kenchangh/kensat/docs/README.md

# Documentation

| Document | Contents |
|---|---|
| [system-architecture.md](system-architecture.md) | The full KENSAT spec: mission, physical stack, processor, interface map and pinouts, operational modes, deployment state machine, reliability, power budget, thermal analysis |
| [radio-guide.md](radio-guide.md) | UHF radio bring-up and operating guide |
| [jetson-startup.md](jetson-startup.md) | Jetson payload boot / inference timing and bring-up |
| [debug-si4463.md](debug-si4463.md) | Si4463 transceiver debugging notes |
| [spi-debug-notes.md](spi-debug-notes.md) | SPI signal-integrity debugging across the board-to-board bus |

> Vendor datasheets and manuals (PIC24 / PPM, Salvo, etc.) are not redistributed
> here; obtain them from the respective vendors.
