kenchangh/kensat/radio/rf-design/before_vna_smith.png

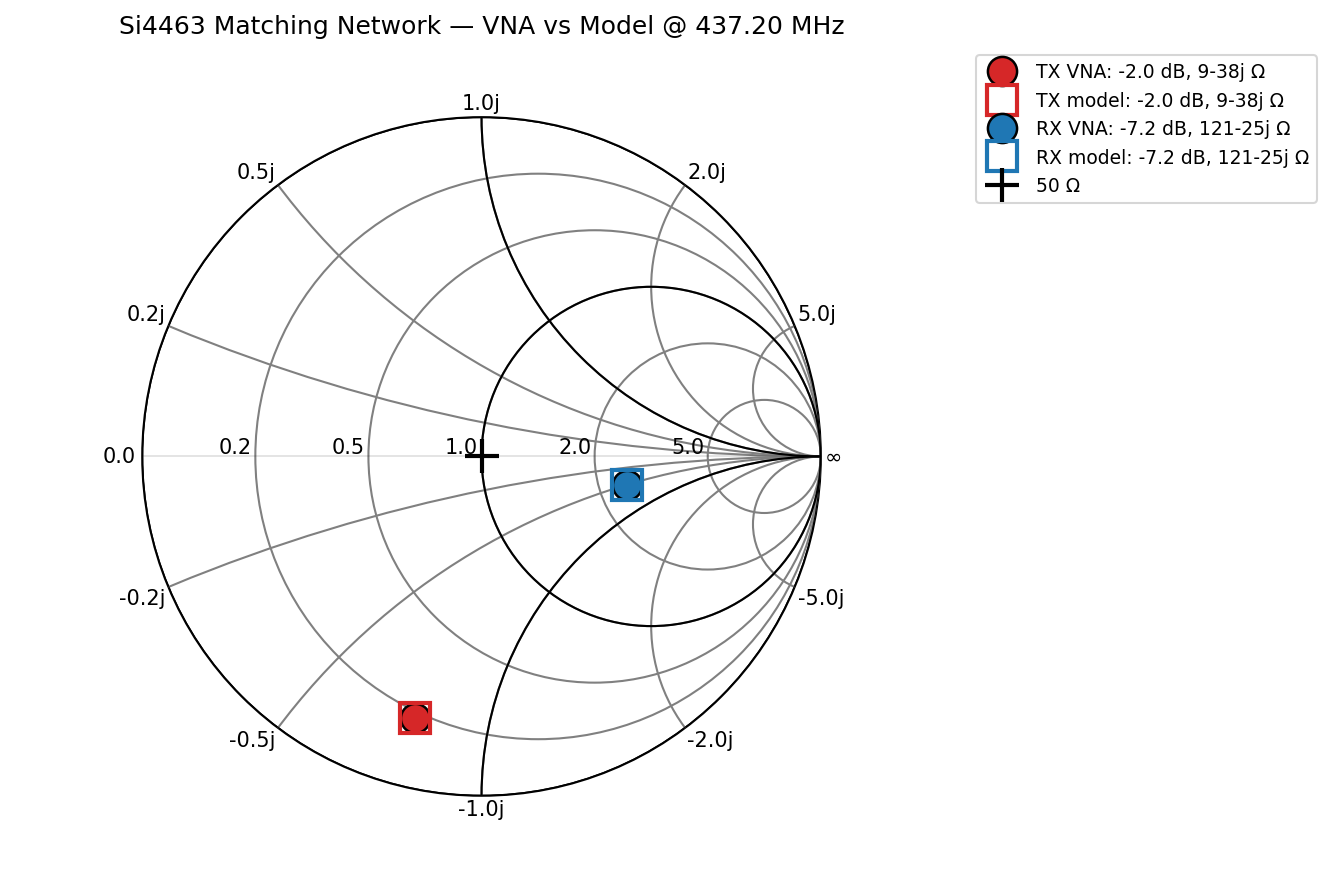
radio/rf-design/before_vna_smith.png
