kenchangh/kensat/radio/rf-design/matching_skrf.png

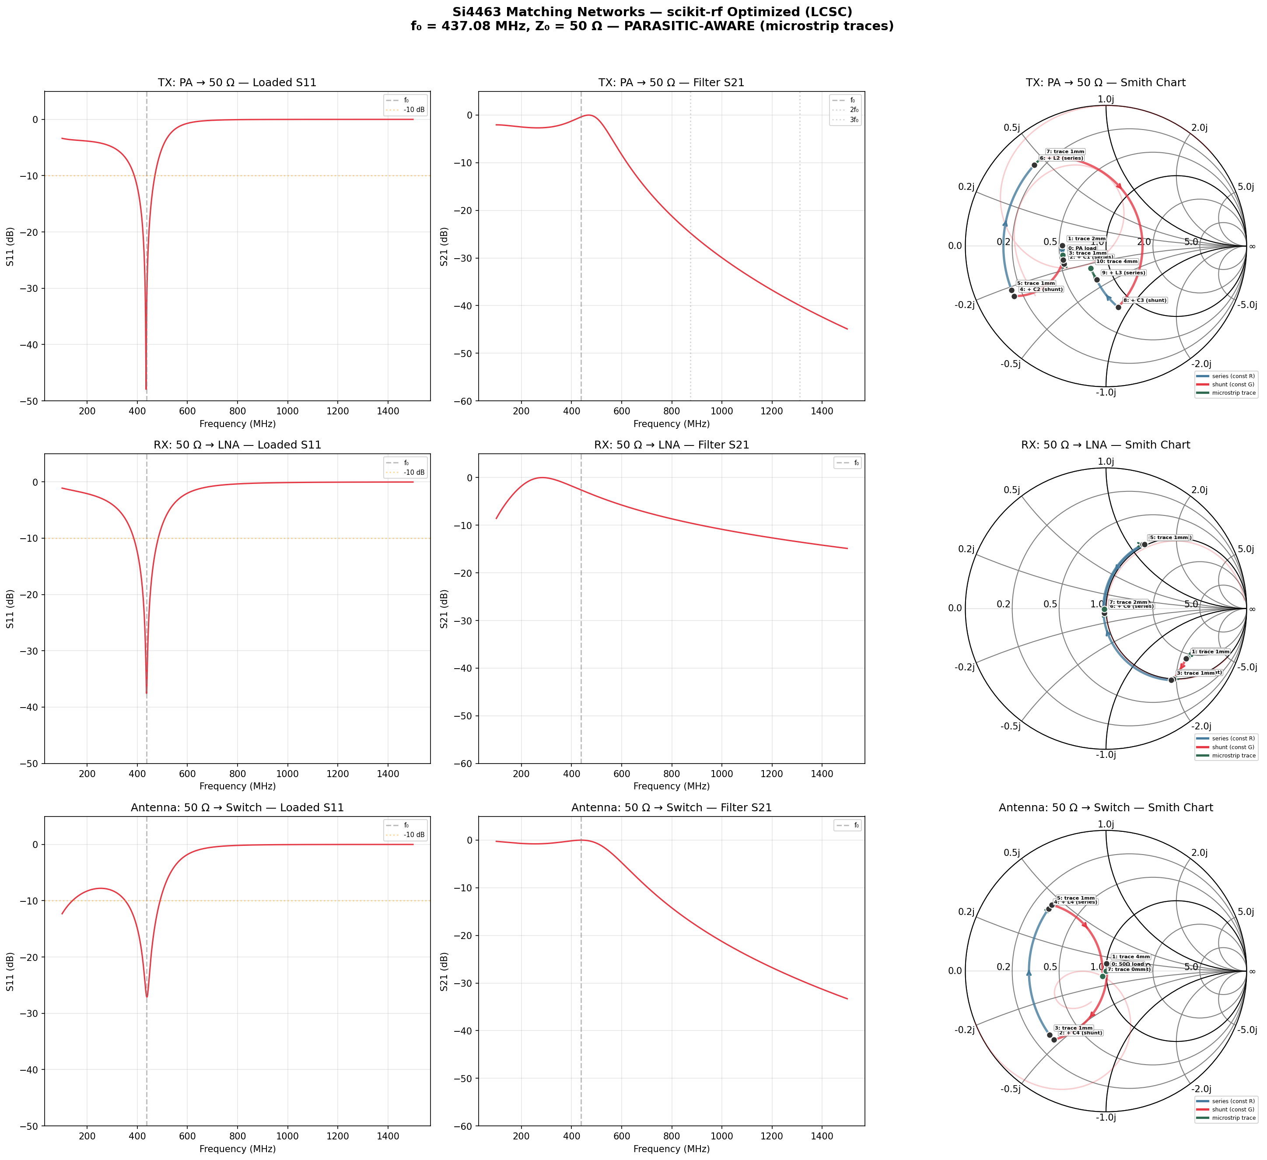
radio/rf-design/matching_skrf.png
