kenchangh/kensat/radio/rf-design/rf_architecture.png

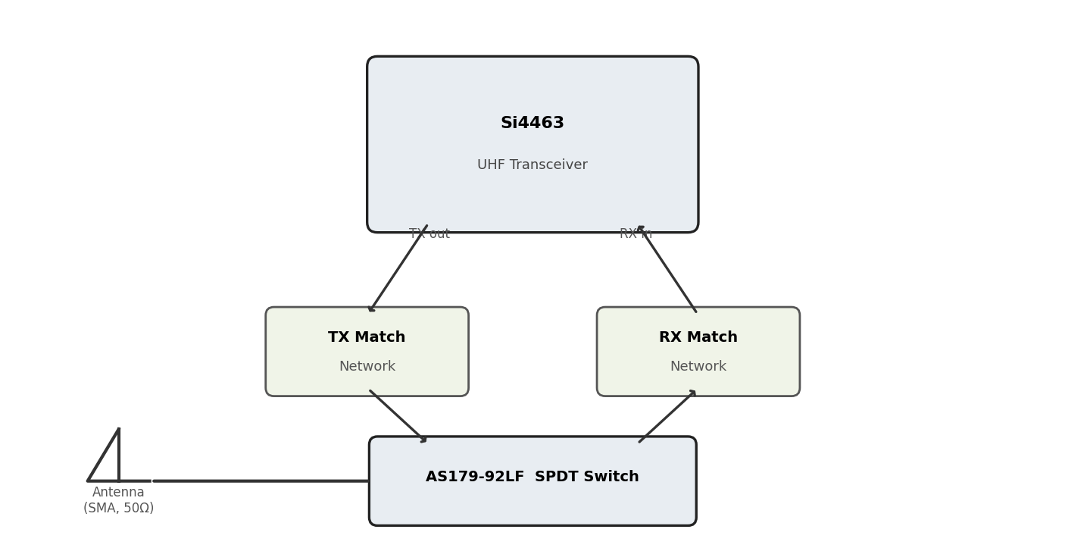
radio/rf-design/rf_architecture.png
