kenchangh/kensat/radio/rf-design/tx_gain_sweep.png

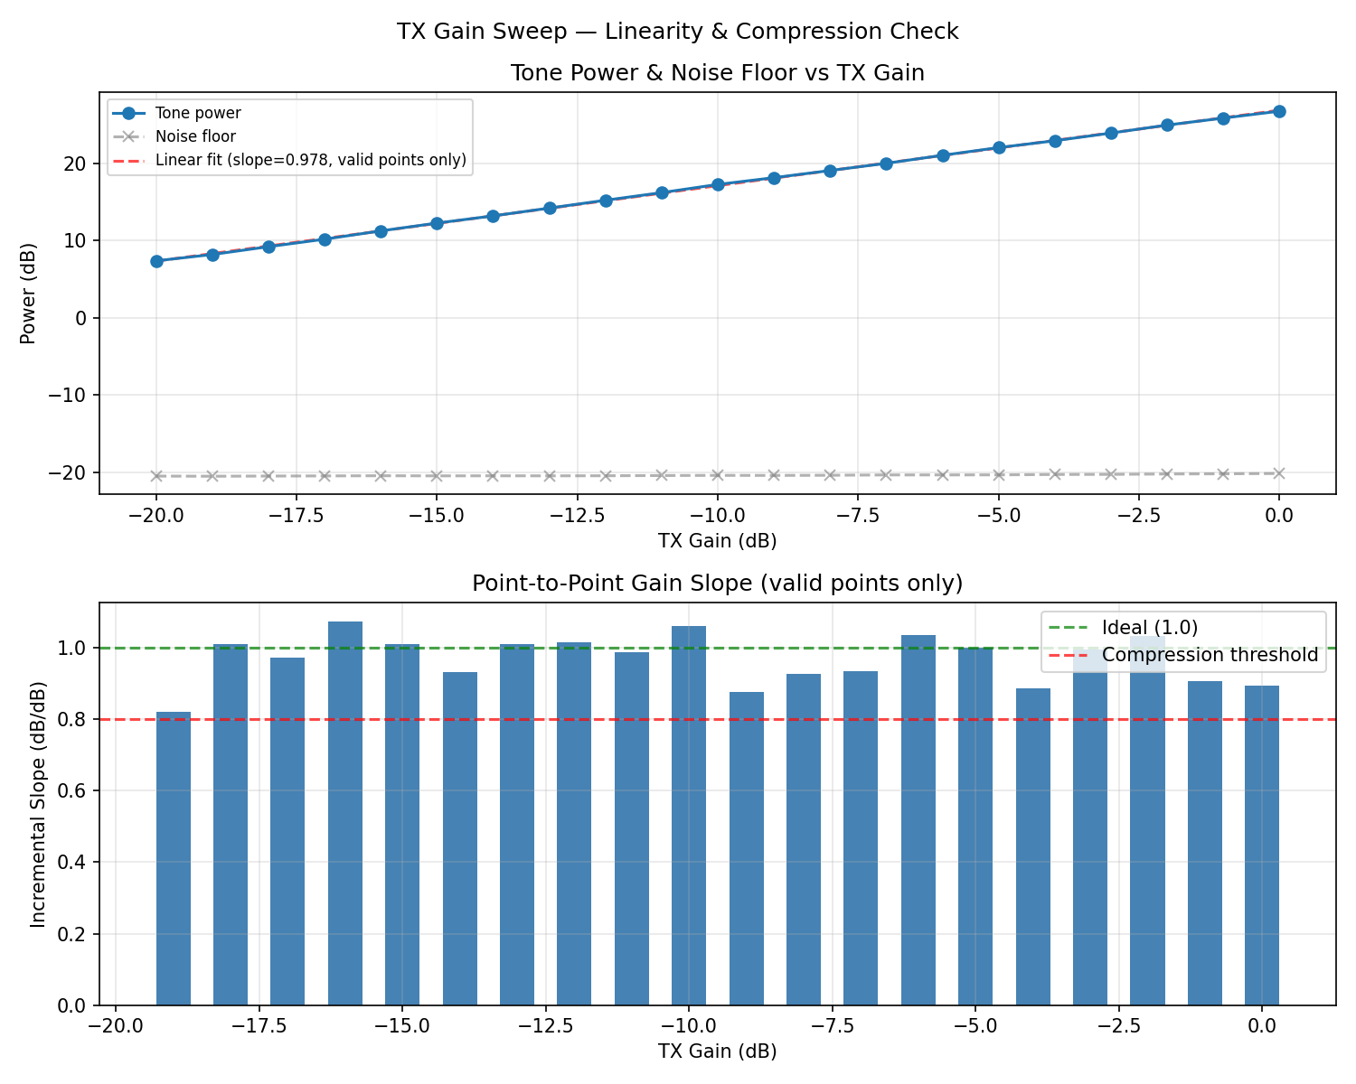
radio/rf-design/tx_gain_sweep.png
