kenchangh/kensat/radio/rf-design/tx_harmonics.png

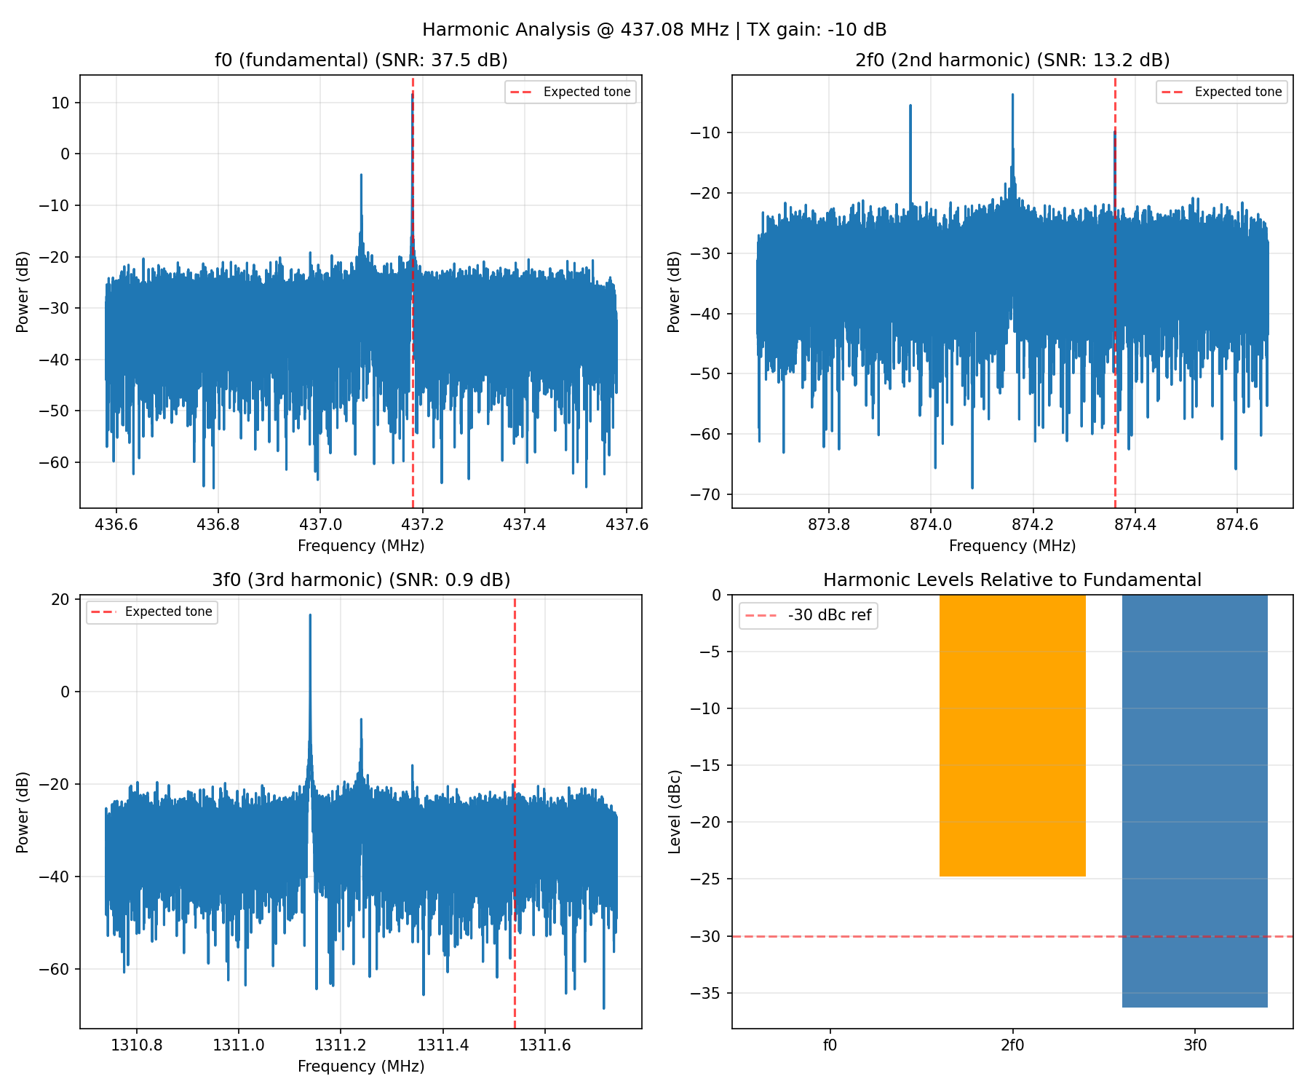
radio/rf-design/tx_harmonics.png
