kenchangh/kensat/radio/rf-design/vna_smith.png

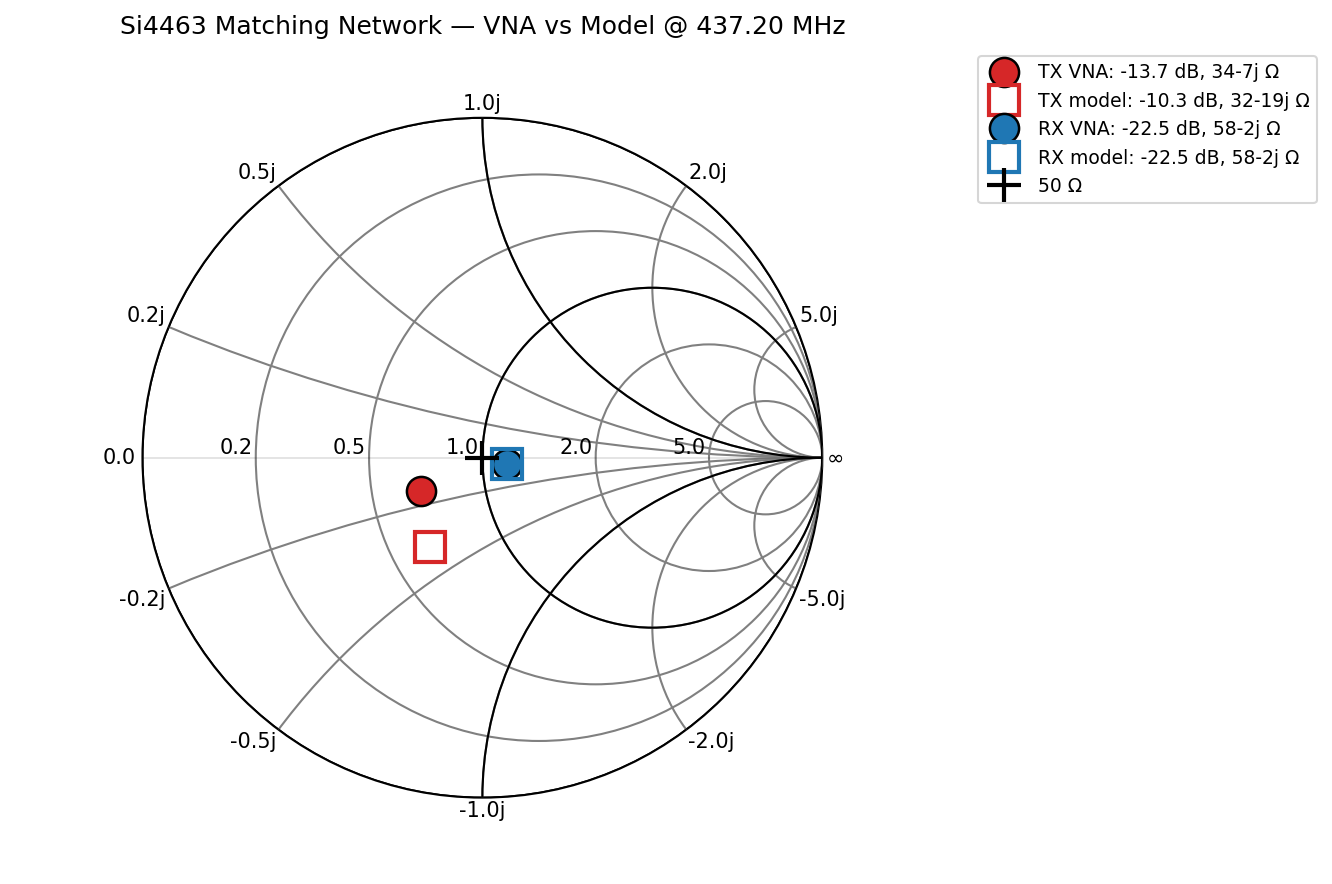
radio/rf-design/vna_smith.png
