kenchangh/kensat/burnwire/hardware/burnwire_bom_jlc.csv

Comment | Designator | Footprint | LCSC Part #
Conn_02x26_Odd_Even | H1,H2 | PinSocket_2x26_P2.54mm_Vertical | C7466599
AO3400A | Q1,Q2 | SOT-23 | C20917
100 | R1,R3 | R_Axial_DIN0207_L6.3mm_D2.5mm_P10.16mm_Horizontal | C120031
100k | R2,R4 | R_Axial_DIN0207_L6.3mm_D2.5mm_P10.16mm_Horizontal | C172965
