kenchangh/kensat/eps/hardware/KENSAT_EPS_v1.2.kicad_pcb

## KiCad design eps/hardware/KENSAT_EPS_v1.2.kicad_pcb (2026-06-17)

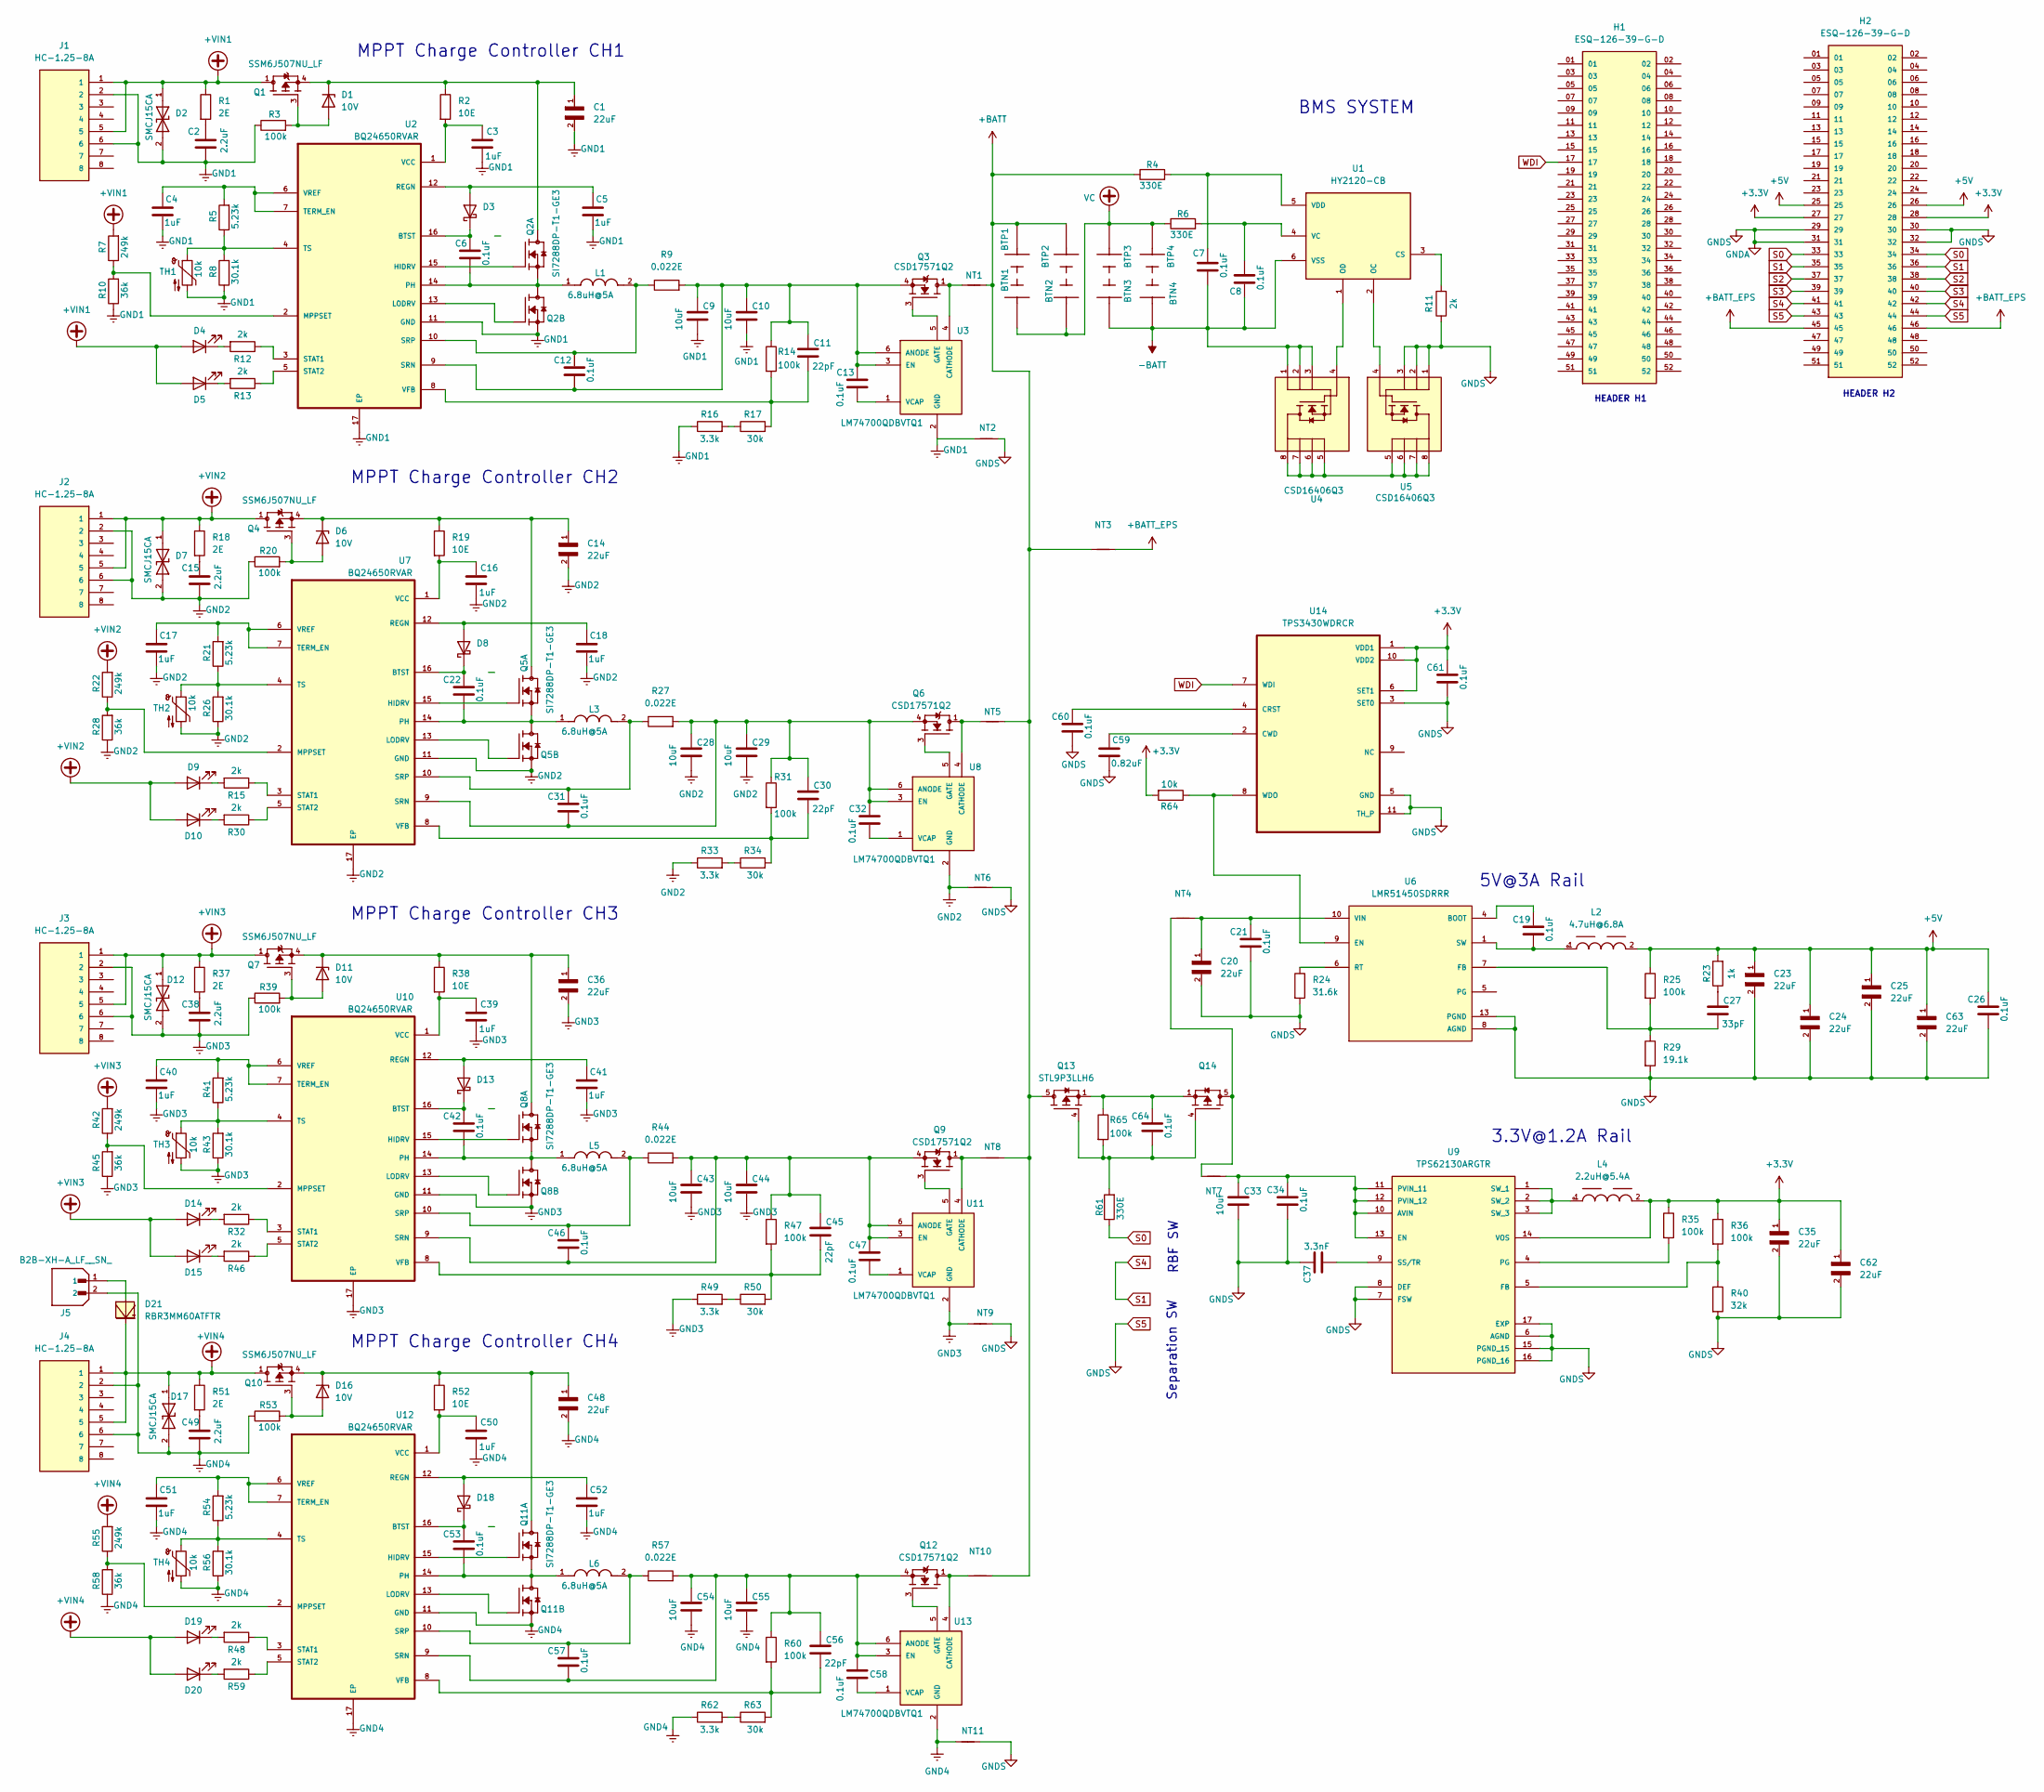
[picture p8: schematic KENSAT_EPS_v1.2.kicad_sch, KENSAT EPS Board]

Parts:
BTN1, BTN2, BTN3, BTN4: MY-18650-02; BAT_254TR; PARTREV C; LCSC Part C2979182
BTP1, BTP2, BTP3, BTP4: MY-18650-02; BAT_254TR; PARTREV C; LCSC Part C2979182
C1, C14, C20, C23, C24, C25, C35, C36, C48, C62, C63: 22uF; CAPC3225X270N; Voltage 35V; LCSC Part C386098
C2, C15, C38, C49: 2.2uF; C_1210_3225Metric; Voltage 100V; LCSC Part C92775
C3, C4, C5, C16, C17, C18, C39, C40, C41, C50, C51, C52: 1uF; C_0603_1608Metric; Voltage 35V; LCSC Part C841050
C6, C7, C8, C12, C13, C19, C21, C22, C26, C31, C32, C34, C42, C46, C47, C53, C57, C58, C60, C61, C64: 0.1uF; C_0603_1608Metric; Voltage 50V; LCSC Part C386155
C9, C10, C28, C29, C33, C43, C44, C54, C55: 10uF; C_1210_3225Metric; Voltage 35V; LCSC Part C2177081
C11, C30, C45, C56: 22pF; C_0603_1608Metric; Voltage 50V; LCSC Part C2169931
C27: 33pF; C_0603_1608Metric; Voltage 16V; LCSC Part C2169365
C37: 3.3nF; C_0603_1608Metric; Voltage 50V; LCSC Part C107088
C59: 0.82uF; C_0603_1608Metric; Voltage 25V; LCSC Part C5360807
D1, D6, D11, D16: 10V; D_SOD-123; LCSC Part C49435551
D2, D7, D12, D17: SMCJ15CA; DIOM7959X262N; PARTREV 11/20/15; LCSC Part C2842380
D3, D8, D13, D18: D_Schottky; D_SOD-323; LCSC Part C151503
D4, D9, D14, D19: LED; R_0603_1608Metric; LCSC Part C125099
D5, D10, D15, D20: LED; R_0603_1608Metric; LCSC Part C125093
D21: RBR3MM60ATFTR; SOD-123FL-2; LCSC Part C559758
H1, H2: ESQ-126-39-G-D; PARTREV R; LCSC Part C7466599
J1, J2, J3, J4: HC-1.25-8A; DF138P125DSA; MOUSER_PART_NUMBER 798-DF13-8P-1.25DSA
J5: B2B-XH-A_LF__SN_; JST_B2B-XH-A_LF__SN_; PARTREV N/A; LCSC Part C158012
L1, L3, L5, L6: 6.8uH@5A; INDDFN420X420X420-2N; PARTREV 09/15/2025; LCSC Part C52988778
L2: 4.7uH@6.8A; WE-XHMI_5030; LCSC Part C50326272
L4: 2.2uH@5.4A; WE-XHMI_5030; LCSC Part C48391578
NT1, NT2, NT3, NT4, NT5, NT6, NT7, NT8, NT9, NT10, NT11: NetTie_2; SolderJumper-2_P1.3mm_Bridged2Bar_Pad1.0x2.5mm
Q1, Q4, Q7, Q10: SSM6J507NU_LF; TRANS_SSM6J507NU_LF; PARTREV 2.0; LCSC Part C146318
Q2, Q5, Q8, Q11: SI7288DP-T1-GE3; TRANS_SI7288DP-T1-GE3; PARTREV A; LCSC Part C126988
Q3, Q6, Q9, Q12: CSD17571Q2; TRANS_CSD17571Q2; PARTREV A; LCSC Part C962382
Q13, Q14: STL9P3LLH6; TRANS_STL9P3LLH6; PARTREV 3; LCSC Part C2969828
R1, R18, R37, R51: 2E; R_2010_5025Metric; LCSC Part C2084800
R2, R19, R38, R52: 10E; R_1206_3216Metric; LCSC Part C304131
R3, R14, R20, R25, R31, R35, R36, R39, R47, R53, R60, R65: 100k; R_0603_1608Metric; LCSC Part C163504
R4, R6, R61: 330E; R_1206_3216Metric; LCSC Part C114944
R5, R21, R41, R54: 5.23k; R_0603_1608Metric; LCSC Part C185317
R7, R22, R42, R55: 249k; R_0603_1608Metric; LCSC Part C311921
R8, R26, R43, R56: 30.1k; R_0603_1608Metric; LCSC Part C137745
R9, R27, R44, R57: 0.022E; R_1206_3216Metric; LCSC Part C875620
R10, R28, R45, R58: 36k; R_0603_1608Metric; LCSC Part C311904
R11, R12, R13, R15, R30, R32, R46, R48, R59: 2k; R_0603_1608Metric; LCSC Part C105576
R16, R33, R49, R62: 3.3k; R_0603_1608Metric; LCSC Part C227493
R17, R34, R50, R63: 30k; R_0603_1608Metric; LCSC Part C700503
R23: 1k; R_1206_3216Metric; LCSC Part C131398
R24: 31.6k; R_0603_1608Metric; LCSC Part C185339
R29: 19.1k; R_0603_1608Metric; LCSC Part C173754
R40: 32k; R_0603_1608Metric; LCSC Part C861325
R64: 10k; R_0603_1608Metric; LCSC Part C98220
TH1, TH2, TH3, TH4: 10k; PinHeader_1x02_P2.00mm_Vertical; LCSC Part C7509625
U1: HY2120-CB; SOT-23-6; PARTREV 1.5_00; LCSC Part C116509
U2, U7, U10, U12: BQ24650RVAR; QFN50P350X350X100-17N; LCSC Part C53712
U3, U8, U11, U13: LM74700QDBVTQ1; SOT95P280X145-6N; PARTREV F; LCSC Part C2653623
U4, U5: CSD16406Q3; TRANS_CSD16406Q3; LCSC Part C2861720
U6: LMR51450SDRRR; CONV_LMR51450SDRRR; PARTREV December 2022; LCSC Part C6890985
U9: TPS62130ARGTR; QFN50P300X300X100-17N; PARTREV E; LCSC Part C337502
U14: TPS3430WDRCR; VREG_V62_16624-01YE; LCSC Part C2870545

Connections:
+3.3V: C35.1, C61.2, C62.1, H2.27, H2.28, L4.2, R35.1, R36.1, R64.2, U9.14 (VOS), U14.1 (VDD1), U14.6 (SET1), U14.10 (VDD2)
+5V: C23.1, C24.1, C25.1, C26.2, C63.1, H2.25, H2.26, L2.2, R23.2, R25.1
+BATT: BTP1.P1, BTP1.P2, BTP2.P1, BTP2.P2, NT1.2, NT3.1, NT5.2, NT8.2, NT10.2, Q13.5, Q13.5_1, Q13.5_2, R4.1
+BATT_EPS: H2.45, H2.46, NT3.2
+VIN1: D2.1, D4.2 (A), D5.2 (A), J1.1, J1.5, Q1.1, Q1.2, Q1.5, Q1.6, Q1.7, R1.1, R7.2
+VIN2: D7.1, D9.2 (A), D10.2 (A), J2.1, J2.5, Q4.1, Q4.2, Q4.5, Q4.6, Q4.7, R18.1, R22.2
+VIN3: D12.1, D14.2 (A), D15.2 (A), J3.1, J3.5, Q7.1, Q7.2, Q7.5, Q7.6, Q7.7, R37.1, R42.2
+VIN4: D17.1, D19.2 (A), D20.2 (A), D21.C, J4.1, J4.5, Q10.1, Q10.2, Q10.5, Q10.6, Q10.7, R51.1, R55.2
-BATT: BTN3.P1, BTN3.P2, BTN4.P1, BTN4.P2, C7.1, C8.1, U1.6 (VSS), U4.1, U4.2, U4.3
GND1: C1.2, C2.2, C3.2, C4.2, C5.2, C9.2, C10.2, D2.2, J1.2, J1.6, NT2.1, Q2.3, R3.1, R8.1, R10.1, R16.1, TH1.2, U2.11 (GND), U2.17 (EP), U3.2 (GND)
GND2: C14.2, C15.2, C16.2, C17.2, C18.2, C28.2, C29.2, D7.2, J2.2, J2.6, NT6.1, Q5.3, R20.1, R26.1, R28.1, R33.1, TH2.2, U7.11 (GND), U7.17 (EP), U8.2 (GND)
GND3: C36.2, C38.2, C39.2, C40.2, C41.2, C43.2, C44.2, D12.2, J3.2, J3.6, NT9.1, Q8.3, R39.1, R43.1, R45.1, R49.1, TH3.2, U10.11 (GND), U10.17 (EP), U11.2 (GND)
GND4: C48.2, C49.2, C50.2, C51.2, C52.2, C54.2, C55.2, D17.2, J4.2, J4.6, J5.2, NT11.1, Q11.3, R53.1, R56.1, R58.1, R62.1, TH4.2, U12.11 (GND), U12.17 (EP), U13.2 (GND)
unnamed: C2.1, R1.2
unnamed: C15.1, R18.2
unnamed: C19.1, L2.1, U6.1 (SW), U6.2 (SW), U6.3 (SW)
unnamed: C20.1, C21.2, NT4.2, U6.10 (VIN), U6.11 (VIN), U6.12 (VIN)
unnamed: C27.1, R23.1
unnamed: C38.1, R37.2
unnamed: C49.1, R51.2
unnamed: C64.1, Q13.4, Q14.4, R61.2, R65.2
unnamed: C64.2, Q13.1, Q13.2, Q13.3, Q14.1, Q14.2, Q14.3, R65.1
unnamed: D1.2 (A), Q1.3, R3.2
unnamed: C1.1, D1.1 (K), Q1.4, Q1.8, Q2.7_8_9, R2.1
unnamed: C5.1, D3.2 (A), U2.12 (REGN)
unnamed: C6.2, D3.1 (K), U2.16 (BTST)
unnamed: D4.1 (K), R12.2
unnamed: D5.1 (K), R13.2
unnamed: D6.2 (A), Q4.3, R20.2
unnamed: C14.1, D6.1 (K), Q4.4, Q4.8, Q5.7_8_9, R19.1
unnamed: C18.1, D8.2 (A), U7.12 (REGN)
unnamed: C22.2, D8.1 (K), U7.16 (BTST)
unnamed: D9.1 (K), R15.2
unnamed: D10.1 (K), R30.2
unnamed: D11.2 (A), Q7.3, R39.2
unnamed: C36.1, D11.1 (K), Q7.4, Q7.8, Q8.7_8_9, R38.1
unnamed: C41.1, D13.2 (A), U10.12 (REGN)
unnamed: C42.2, D13.1 (K), U10.16 (BTST)
unnamed: D14.1 (K), R32.2
unnamed: D15.1 (K), R46.2
unnamed: D16.2 (A), Q10.3, R53.2
unnamed: C48.1, D16.1 (K), Q10.4, Q10.8, Q11.7_8_9, R52.1
unnamed: C52.1, D18.2 (A), U12.12 (REGN)
unnamed: C53.2, D18.1 (K), U12.16 (BTST)
unnamed: D19.1 (K), R48.2
unnamed: D20.1 (K), R59.2
unnamed: D21.A, J5.1
unnamed: NT4.1, NT7.1, Q14.5, Q14.5_1, Q14.5_2
unnamed: R16.2, R17.1
unnamed: R33.2, R34.1
unnamed: R49.2, R50.1
unnamed: R62.2, R63.1
unnamed: R11.2, U1.3 (CS)
unnamed: U1.2 (OC), U5.4
unnamed: U1.1 (OD), U4.4
unnamed: C8.2, R6.2, U1.4 (VC)
unnamed: C7.2, R4.2, U1.5 (VDD)
unnamed: Q2.2, U2.15 (HIDRV)
unnamed: Q2.4, U2.13 (LODRV)
unnamed: R7.1, R10.2, U2.2 (MPPSET)
unnamed: C6.1, L1.1, Q2.1, Q2.5_6_10, U2.14 (PH)
unnamed: C9.1, C10.1, C11.1, C12.1, C13.2, Q3.4, Q3.8, R9.2, R14.1, U2.9 (SRN), U3.3 (EN), U3.6 (ANODE)
unnamed: C12.2, L1.2, R9.1, U2.10 (SRP)
unnamed: R12.1, U2.3 (STAT1)
unnamed: R13.1, U2.5 (STAT2)
unnamed: C4.1, R5.2, U2.6 (VREF), U2.7 (TERM_EN)
unnamed: R5.1, R8.2, TH1.1, U2.4 (TS)
unnamed: C3.1, R2.2, U2.1 (VCC)
unnamed: C11.2, R14.2, R17.2, U2.8 (VFB)
unnamed: NT1.1, Q3.1, Q3.2, Q3.5, Q3.6, Q3.7, U3.4 (CATHODE)
unnamed: Q3.3, U3.5 (GATE)
unnamed: C13.1, U3.1 (VCAP)
unnamed: U4.5, U4.6, U4.7, U4.8, U5.5, U5.6, U5.7, U5.8
unnamed: C19.2, U6.4 (BOOT)
unnamed: C27.2, R25.2, R29.1, U6.7 (FB)
unnamed: R24.1, U6.6 (RT)
unnamed: Q5.2, U7.15 (HIDRV)
unnamed: Q5.4, U7.13 (LODRV)
unnamed: R22.1, R28.2, U7.2 (MPPSET)
unnamed: C22.1, L3.1, Q5.1, Q5.5_6_10, U7.14 (PH)
unnamed: C28.1, C29.1, C30.1, C31.1, C32.2, Q6.4, Q6.8, R27.2, R31.1, U7.9 (SRN), U8.3 (EN), U8.6 (ANODE)
unnamed: C31.2, L3.2, R27.1, U7.10 (SRP)
unnamed: R15.1, U7.3 (STAT1)
unnamed: R30.1, U7.5 (STAT2)
unnamed: C17.1, R21.2, U7.6 (VREF), U7.7 (TERM_EN)
unnamed: R21.1, R26.2, TH2.1, U7.4 (TS)
unnamed: C16.1, R19.2, U7.1 (VCC)
unnamed: C30.2, R31.2, R34.2, U7.8 (VFB)
unnamed: NT5.1, Q6.1, Q6.2, Q6.5, Q6.6, Q6.7, U8.4 (CATHODE)
unnamed: Q6.3, U8.5 (GATE)
unnamed: C32.1, U8.1 (VCAP)
unnamed: C33.1, C34.2, NT7.2, U9.10 (AVIN), U9.11 (PVIN_11), U9.12 (PVIN_12), U9.13 (EN)
unnamed: R36.2, R40.1, U9.5 (FB)
unnamed: R35.2, U9.4 (PG)
unnamed: C37.1, U9.9 (SS/TR)
unnamed: L4.1, U9.1 (SW_1), U9.2 (SW_2), U9.3 (SW_3)
unnamed: Q8.2, U10.15 (HIDRV)
unnamed: Q8.4, U10.13 (LODRV)
unnamed: R42.1, R45.2, U10.2 (MPPSET)
unnamed: C42.1, L5.1, Q8.1, Q8.5_6_10, U10.14 (PH)
unnamed: C43.1, C44.1, C45.1, C46.1, C47.2, Q9.4, Q9.8, R44.2, R47.1, U10.9 (SRN), U11.3 (EN), U11.6 (ANODE)
unnamed: C46.2, L5.2, R44.1, U10.10 (SRP)
unnamed: R32.1, U10.3 (STAT1)
unnamed: R46.1, U10.5 (STAT2)
unnamed: C40.1, R41.2, U10.6 (VREF), U10.7 (TERM_EN)
unnamed: R41.1, R43.2, TH3.1, U10.4 (TS)
unnamed: C39.1, R38.2, U10.1 (VCC)
unnamed: C45.2, R47.2, R50.2, U10.8 (VFB)
unnamed: NT8.1, Q9.1, Q9.2, Q9.5, Q9.6, Q9.7, U11.4 (CATHODE)
unnamed: Q9.3, U11.5 (GATE)
unnamed: C47.1, U11.1 (VCAP)
unnamed: Q11.2, U12.15 (HIDRV)
unnamed: Q11.4, U12.13 (LODRV)
unnamed: R55.1, R58.2, U12.2 (MPPSET)
unnamed: C53.1, L6.1, Q11.1, Q11.5_6_10, U12.14 (PH)
unnamed: C54.1, C55.1, C56.1, C57.1, C58.2, Q12.4, Q12.8, R57.2, R60.1, U12.9 (SRN), U13.3 (EN), U13.6 (ANODE)
unnamed: C57.2, L6.2, R57.1, U12.10 (SRP)
unnamed: R48.1, U12.3 (STAT1)
unnamed: R59.1, U12.5 (STAT2)
unnamed: C51.1, R54.2, U12.6 (VREF), U12.7 (TERM_EN)
unnamed: R54.1, R56.2, TH4.1, U12.4 (TS)
unnamed: C50.1, R52.2, U12.1 (VCC)
unnamed: C56.2, R60.2, R63.2, U12.8 (VFB)
unnamed: NT10.1, Q12.1, Q12.2, Q12.5, Q12.6, Q12.7, U13.4 (CATHODE)
unnamed: Q12.3, U13.5 (GATE)
unnamed: C58.1, U13.1 (VCAP)
unnamed: C60.2, U14.4 (CRST)
unnamed: C59.1, U14.2 (CWD)
unnamed: R64.1, U6.9 (EN), U14.8 (WDO)
S0: H2.33, H2.34, R61.1
S1: H2.35, H2.36, H2.41, H2.42
S2: H2.37, H2.38
S3: H2.39, H2.40
S5: C20.2, C21.1, C23.2, C24.2, C25.2, C26.1, C33.2, C34.1, C35.2, C37.2, C59.2, C60.1, C61.1, C62.2, C63.2, H2.29, H2.30, H2.31, H2.32, H2.43, H2.44, NT2.2, NT6.2, NT9.2, NT11.2, R11.1, R24.2, R29.2, R40.2, U5.1, U5.2, U5.3, U6.8 (AGND), U6.13 (PGND), U9.6 (AGND), U9.7 (FSW), U9.8 (DEF), U9.15 (PGND_15), U9.16 (PGND_16), U9.17 (EXP), U14.3 (SET0), U14.5 (GND), U14.11 (TH_P)
VC: BTN1.P1, BTN1.P2, BTN2.P1, BTN2.P2, BTP3.P1, BTP3.P2, BTP4.P1, BTP4.P2, R6.1
WDI: H1.17 (17_17), U14.7 (WDI)

Notes on the sheet:
MPPT Charge Controller CH3
MPPT Charge Controller CH4
MPPT Charge Controller CH1
HEADER H1
RBF SW
Separation SW
BMS SYSTEM
3.3V@1.2A Rail
MPPT Charge Controller CH2
HEADER H2
5V@3A Rail

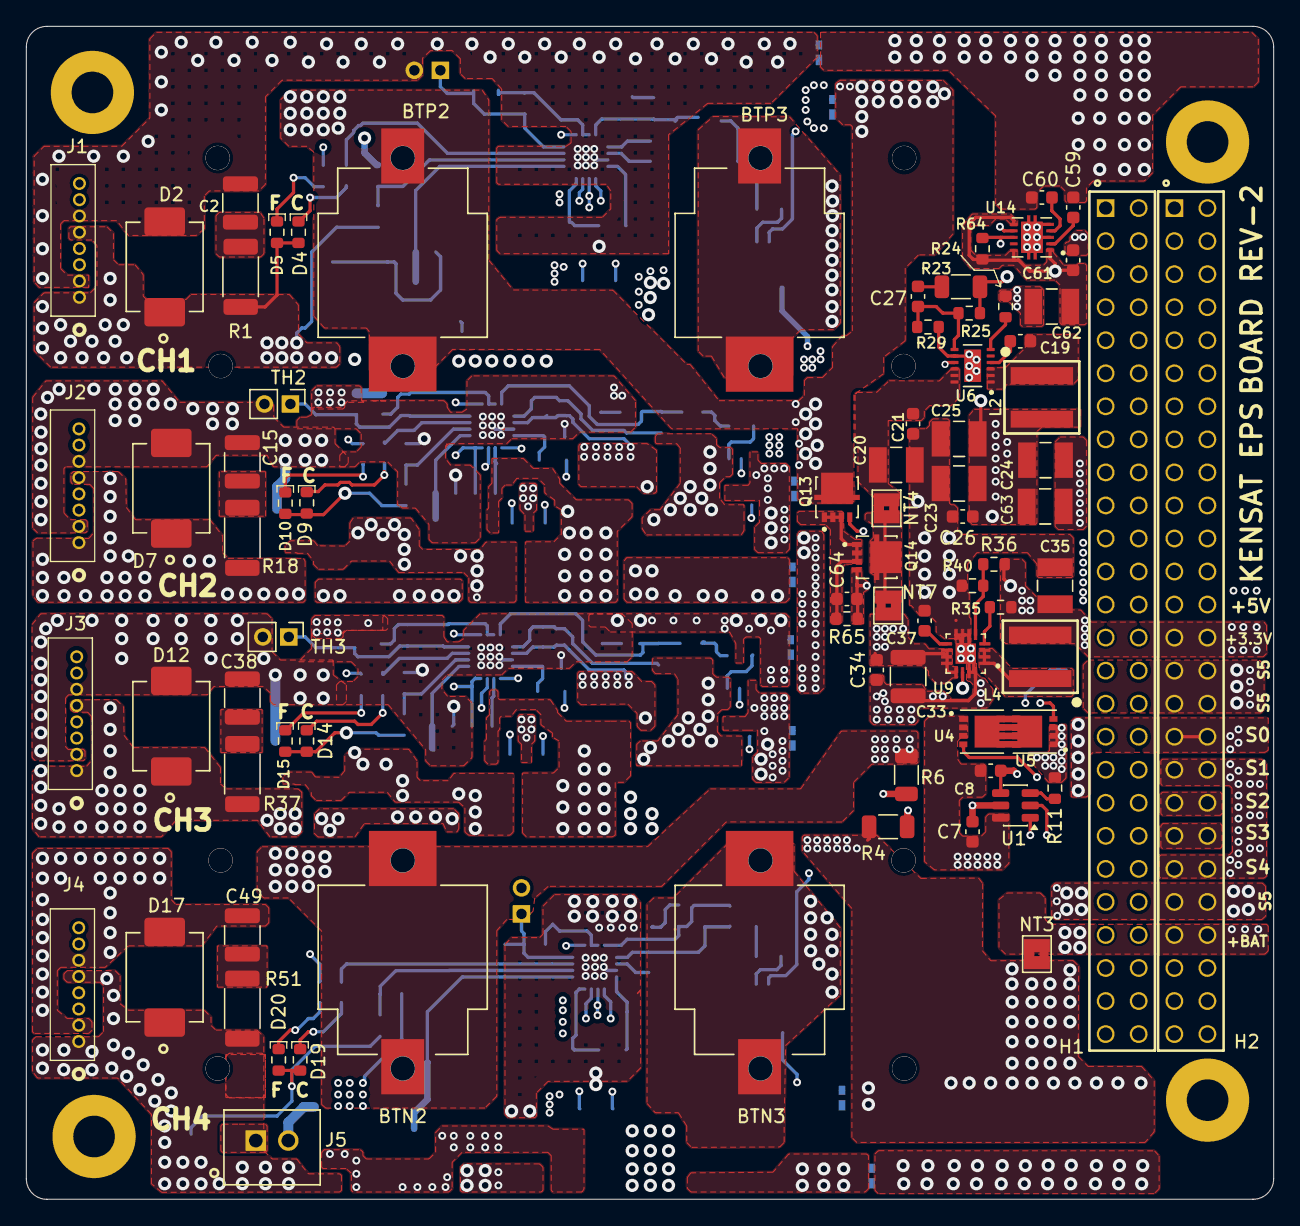
[picture p9: board KENSAT_EPS_v1.2.kicad_pcb from above]

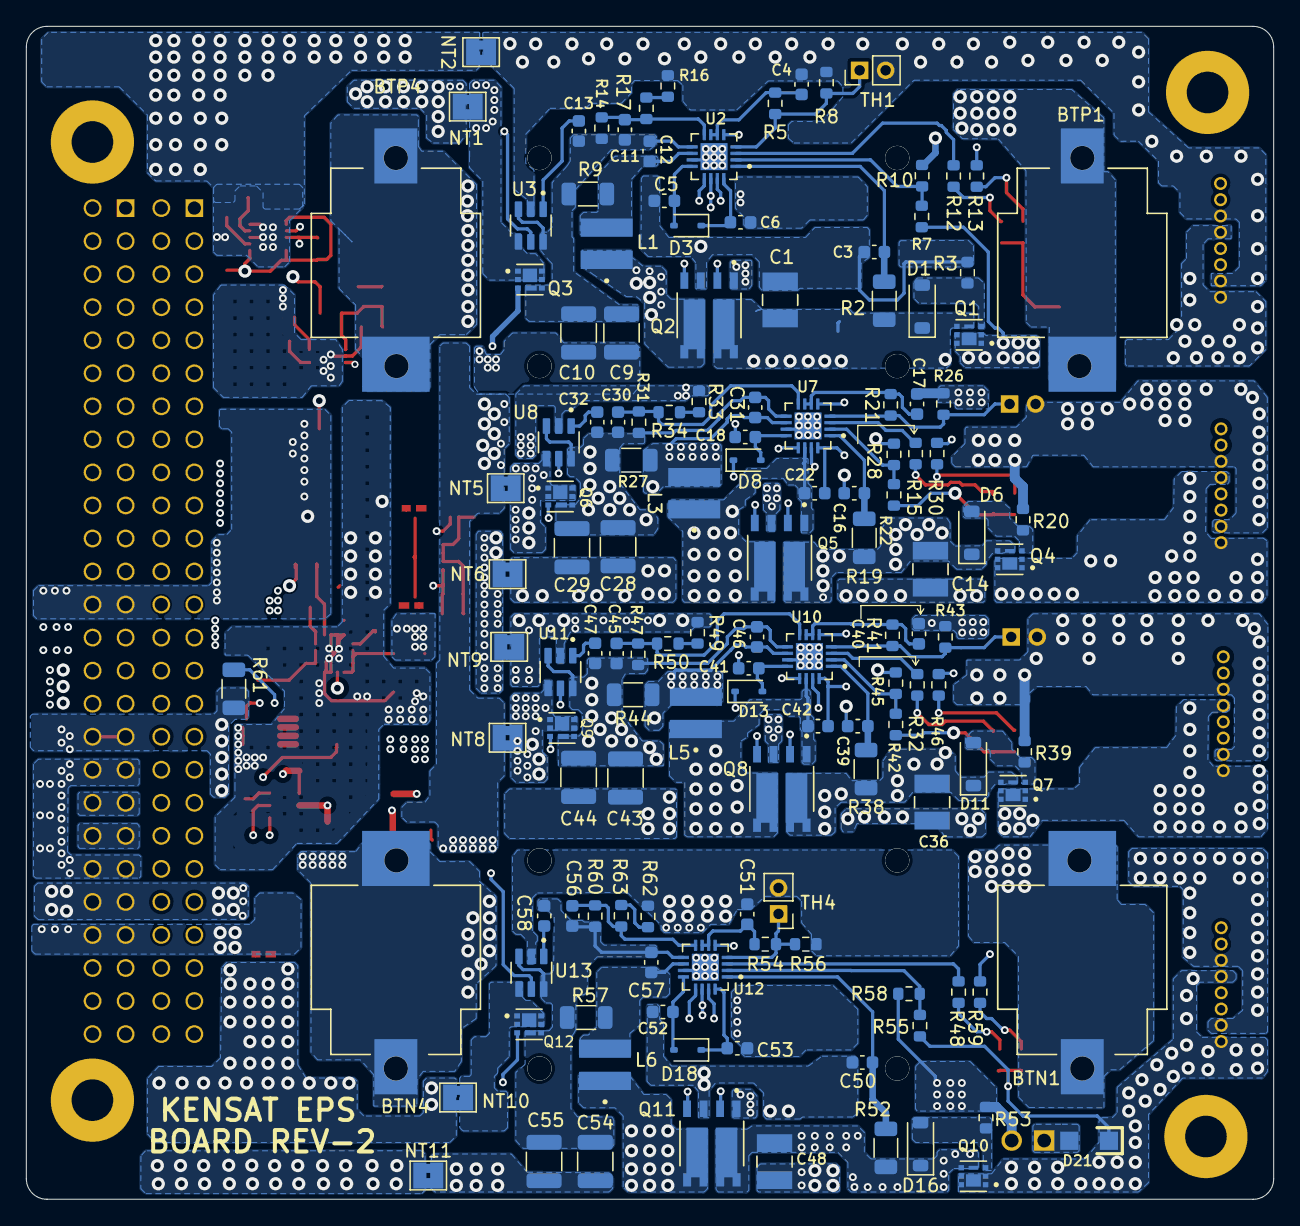
[picture p10: board KENSAT_EPS_v1.2.kicad_pcb from below]

Board: 4 copper layers, 95.9 x 90.2 mm, 214 parts (136 on the bottom side), 136 nets.
