kenchangh/kensat/burnwire/hardware/burnwire.kicad_pcb

## KiCad design burnwire/hardware/burnwire.kicad_pcb (2026-06-17)

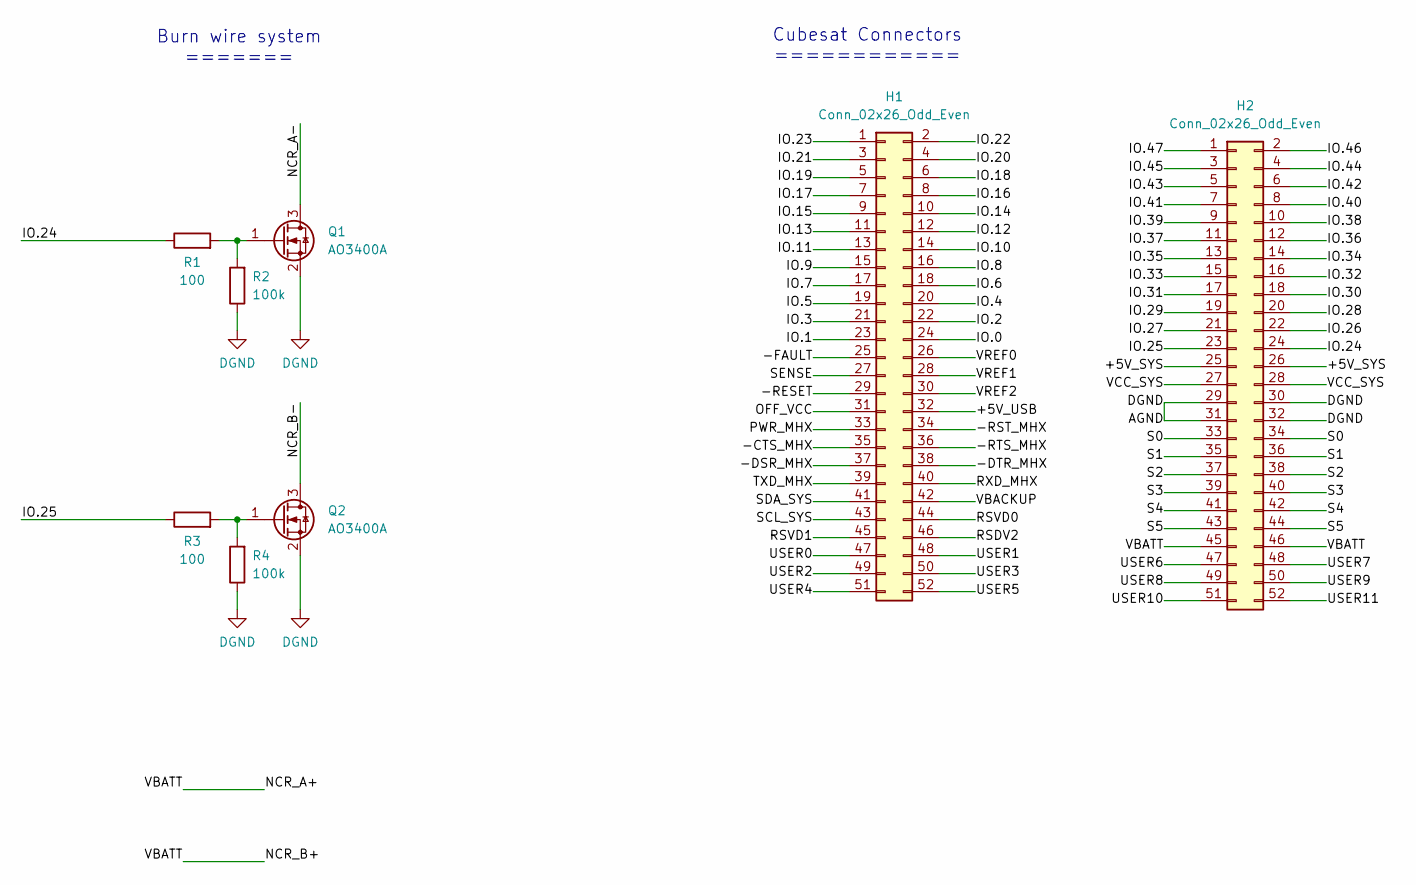
[picture p11: schematic burnwire.kicad_sch]

Parts:
H1, H2: Conn_02x26_Odd_Even; PinSocket_2x26_P2.54mm_Vertical
Q1, Q2: AO3400A; SOT-23
R1, R3: 100; R_Axial_DIN0207_L6.3mm_D2.5mm_P10.16mm_Horizontal
R2, R4: 100k; R_Axial_DIN0207_L6.3mm_D2.5mm_P10.16mm_Horizontal

Connections:
/+5V_SYS: H2.25, H2.26
/+5V_USB: H1.32
/-CTS_MHX: H1.35
/-DSR_MHX: H1.37
/-DTR_MHX: H1.38
/-FAULT: H1.25
/-RESET: H1.29
/-RST_MHX: H1.34
/-RTS_MHX: H1.36
/IO.0: H1.24
/IO.1: H1.23
/IO.2: H1.22
/IO.3: H1.21
/IO.4: H1.20
/IO.5: H1.19
/IO.6: H1.18
/IO.7: H1.17
/IO.8: H1.16
/IO.9: H1.15
/IO.10: H1.14
/IO.11: H1.13
/IO.12: H1.12
/IO.13: H1.11
/IO.14: H1.10
/IO.15: H1.9
/IO.16: H1.8
/IO.17: H1.7
/IO.18: H1.6
/IO.19: H1.5
/IO.20: H1.4
/IO.21: H1.3
/IO.22: H1.2
/IO.23: H1.1
/IO.24: H2.24, R1.1
/IO.25: H2.23, R3.1
/IO.26: H2.22
/IO.27: H2.21
/IO.28: H2.20
/IO.29: H2.19
/IO.30: H2.18
/IO.31: H2.17
/IO.32: H2.16
/IO.33: H2.15
/IO.34: H2.14
/IO.35: H2.13
/IO.36: H2.12
/IO.37: H2.11
/IO.38: H2.10
/IO.39: H2.9
/IO.40: H2.8
/IO.41: H2.7
/IO.42: H2.6
/IO.43: H2.5
/IO.44: H2.4
/IO.45: H2.3
/IO.46: H2.2
/IO.47: H2.1
/NCR_A-: Q1.3 (D)
/NCR_B-: Q2.3 (D)
/OFF_VCC: H1.31
/PWR_MHX: H1.33
/RSDV2: H1.46
/RSVD0: H1.44
/RSVD1: H1.45
/RXD_MHX: H1.40
/S0: H2.33, H2.34
/S1: H2.35, H2.36
/S2: H2.37, H2.38
/S3: H2.39, H2.40
/S4: H2.41, H2.42
/S5: H2.43, H2.44
/SCL_SYS: H1.43
/SDA_SYS: H1.41
/SENSE: H1.27
/TXD_MHX: H1.39
/USER0: H1.47
/USER1: H1.48
/USER2: H1.49
/USER3: H1.50
/USER4: H1.51
/USER5: H1.52
/USER6: H2.47
/USER7: H2.48
/USER8: H2.49
/USER9: H2.50
/USER10: H2.51
/USER11: H2.52
/VBACKUP: H1.42
/VBATT: H2.45, H2.46
/VCC_SYS: H2.27, H2.28
/VREF0: H1.26
/VREF1: H1.28
/VREF2: H1.30
DGND: H2.29, H2.30, H2.31, H2.32, Q1.2 (S), Q2.2 (S), R2.1, R4.1
unnamed: Q1.1 (G), R1.2, R2.2
unnamed: Q2.1 (G), R3.2, R4.2

Notes on the sheet:
Burn wire system =======
Cubesat Connectors ============

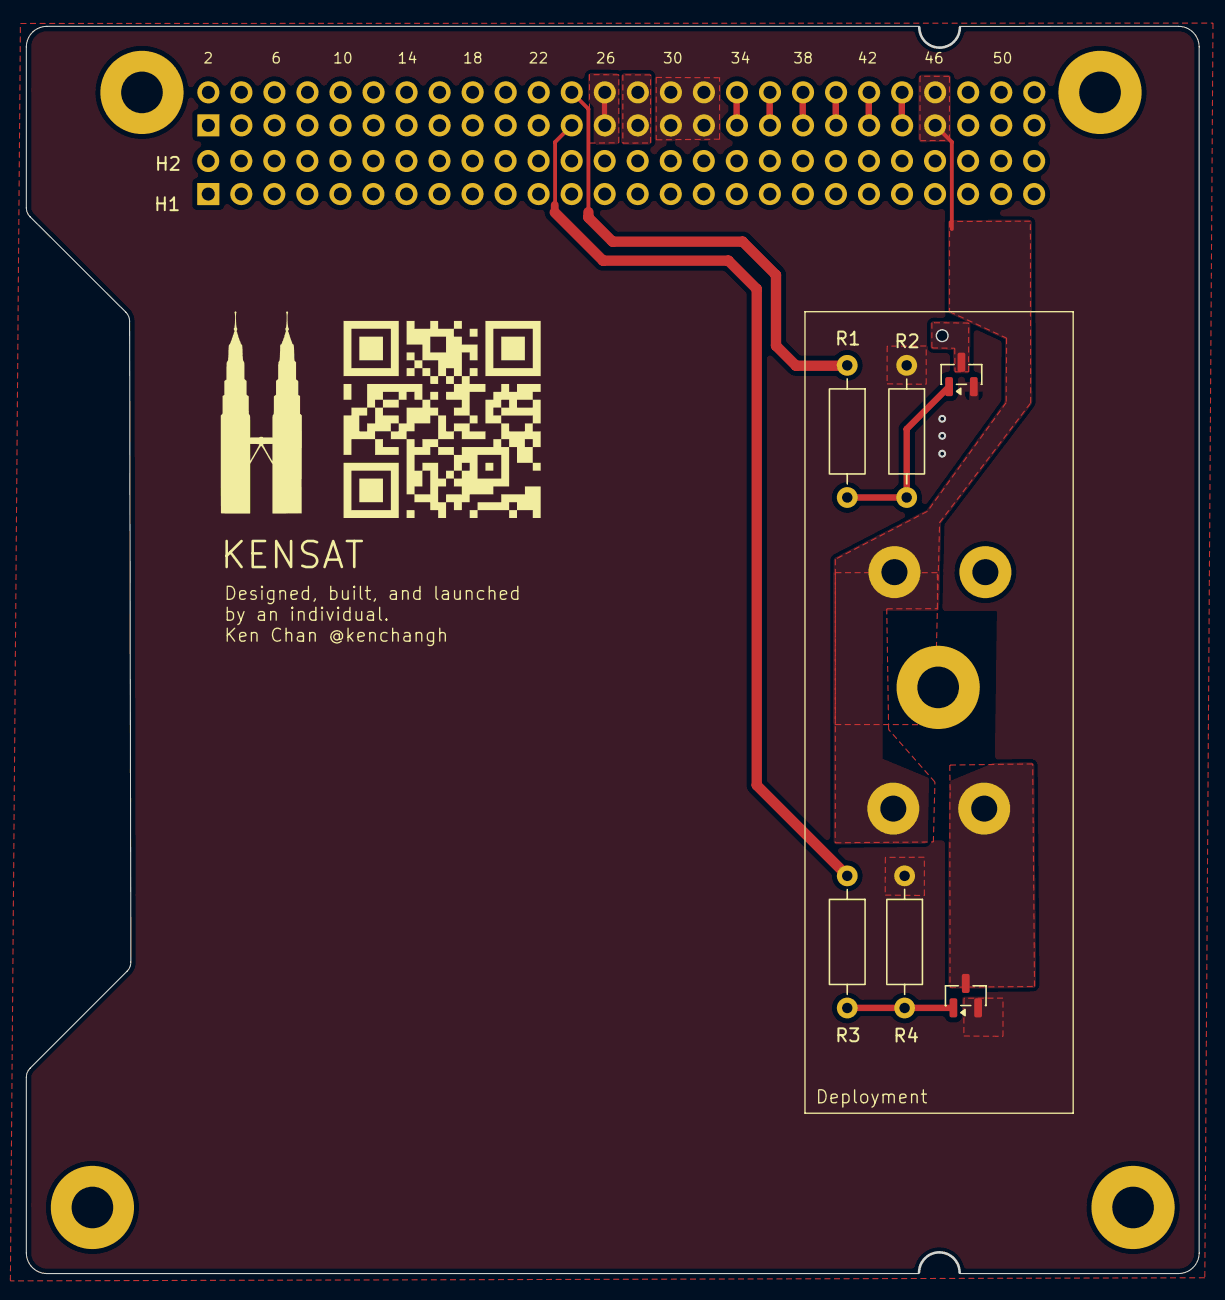
[picture p12: board burnwire.kicad_pcb from above]

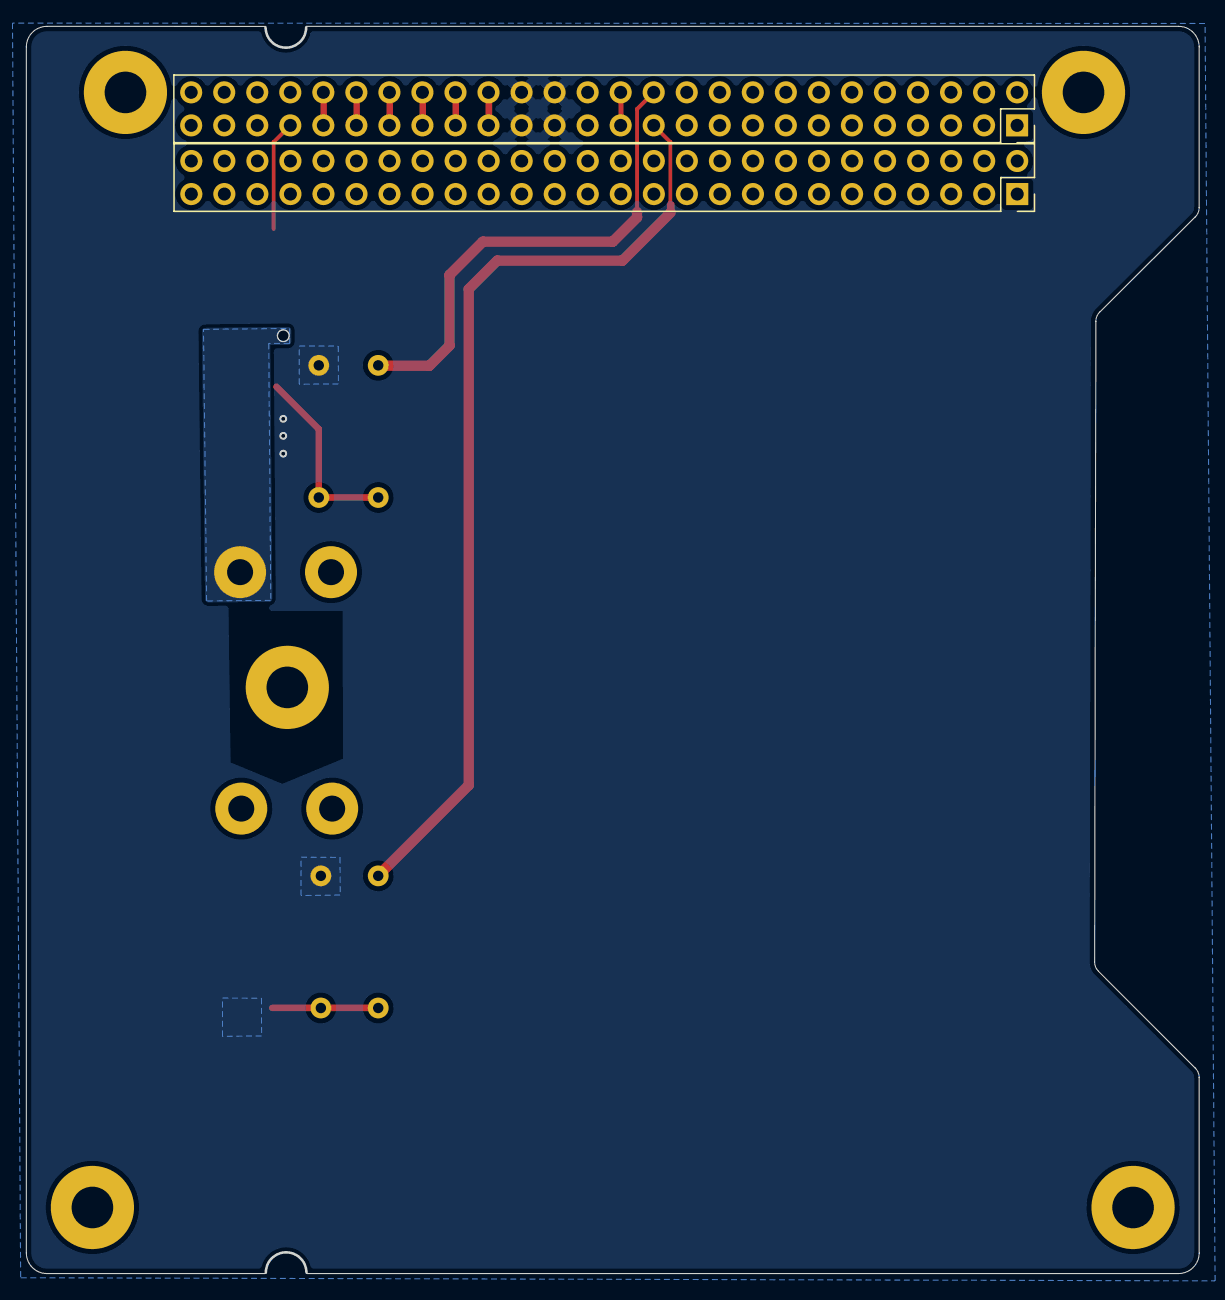
[picture p13: board burnwire.kicad_pcb from below]

Board: 2 copper layers, 90.2 x 95.9 mm, 8 parts (2 on the bottom side), 14 nets.
