kenchangh/kensat/firmware/obc/bsp/csk_io.h

/******************************************************************************
(C) Copyright Pumpkin, Inc. All Rights Reserved.

This file may be distributed under the terms of the License
Agreement provided with this software.

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
$Source: C:\\RCS\\D\\Pumpkin\\CubeSatKit\\PIC24\\Inc\\csk_io.h,v $
$Author: aek $
$Revision: 3.2 $
$Date: 2010-01-24 20:37:06-08 $

******************************************************************************/
#ifndef __csk_io_h
#define __csk_io_h

// Bit definitions.
#define BIT0  (1 <<  0)
#define BIT1  (1 <<  1)
#define BIT2  (1 <<  2)
#define BIT3  (1 <<  3)
#define BIT4  (1 <<  4)
#define BIT5  (1 <<  5)
#define BIT6  (1 <<  6)
#define BIT7  (1 <<  7)
#define BIT8  (1 <<  8)
#define BIT9  (1 <<  9)
#define BIT10 (1 << 10)
#define BIT11 (1 << 11)
#define BIT12 (1 << 12)
#define BIT13 (1 << 13)
#define BIT14 (1 << 14)
#define BIT15 (1 << 15)


extern void csk_io0_high(void);
extern void csk_io0_low(void);
extern void csk_io1_high(void);
extern void csk_io1_low(void);
extern void csk_io2_high(void);
extern void csk_io2_low(void);
extern void csk_io3_high(void);
extern void csk_io3_low(void);
extern void csk_io4_high(void);
extern void csk_io4_low(void);
extern void csk_io5_high(void);
extern void csk_io5_low(void);
extern void csk_io6_high(void);
extern void csk_io6_low(void);
extern void csk_io7_high(void);
extern void csk_io7_low(void);

extern void csk_io8_high(void);
extern void csk_io8_low(void);
extern void csk_io9_high(void);
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
extern void csk_io44_high(void);
extern void csk_io44_low(void);
extern void csk_io45_high(void);
extern void csk_io45_low(void);
extern void csk_io46_high(void);
extern void csk_io46_low(void);
extern void csk_io47_high(void);
extern void csk_io47_low(void);


#endif /* __csk_io_h */
