kenchangh/kensat/firmware/obc/bsp/csk_uart.h

/******************************************************************************
(C) Copyright Pumpkin, Inc. All Rights Reserved.

This file may be distributed under the terms of the License
Agreement provided with this software.

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
$Source: C:\\RCS\\D\\Pumpkin\\CubeSatKit\\PIC24\\Inc\\csk_uart.h,v $
$Author: aek $
$Revision: 3.4 $
$Date: 2010-06-10 21:36:15-07 $

******************************************************************************/
#ifndef __csk_uart_h
#define __csk_uart_h


// Microchip's peripheral library functions
#include <uart.h>

// Pumpkin PIC24 library functions
#include "pic24_uart.h"
#include "pic24_uart_msg.h"
#include "pic24_uart_msg_ts.h"

// Aliases for commonly-used functions that are pulled from the
//  Microchip PIC24F Peripheral Library
#define CSK_UART_9600_N81              UART_9600_N81_MAIN
#define CSK_UART_115200_N81            UART_115200_N81_MAIN

// CSK UART0 <==> PIC24 UART1
#define csk_uart0_close()              uart1_close()
#define csk_uart0_inchar(x)            uart1_inchar(x)
#define csk_uart0_getchar()            uart1_getchar()
#define csk_uart0_open(x)              uart1_open(x)
#define csk_uart0_msg(x)               uart1_msg(x)
#define csk_uart0_msg_ts(x)            uart1_msg_ts(x)
#define csk_uart0_outchar()            uart1_outchar()
#define csk_uart0_putchar(x)           uart1_putchar(x)
#define csk_uart0_puts(x)              uart1_puts(x)

// CSK UART1 <==> PIC24 UART2
#define csk_uart1_close()              uart2_close()
#define csk_uart1_inchar(x)            uart2_inchar(x)
#define csk_uart1_getchar()            uart2_getchar()
#define csk_uart1_open(x)              uart2_open(x)
#define csk_uart1_msg(x)               uart2_msg(x)
#define csk_uart1_msg_ts(x)            uart2_msg_ts(x)
#define csk_uart1_outchar()            uart2_outchar()
#define csk_uart1_putchar(x)           uart2_putchar(x)
#define csk_uart1_puts(x)              uart2_puts(x)


#endif /* __csk_uart_h */
