kenchangh/kensat/(commit log)

2026-06-17 Consolidate KENSAT CubeSat into a single repository
    Bring the full 2U CubeSat project together from three formerly separate
    working directories (radio, burnwire, OBC/Pumpkin) into one structured,
    portfolio-ready repo:
    - firmware/obc — PIC24 flight software (app/ mission logic + bsp/ drivers)
    - radio — Si4463 UHF board: ESP32 firmware, KiCad design, RF matching
    - eps — electrical power system board (KiCad)
    - burnwire — antenna-deployment board (KiCad)
    - jetson — Jetson Orin Nano edge-AI payload daemon + systemd units
    - ground-station— ADALM-Pluto SDR RX/TX, AX.25 decoder, DSP diagnostics
    - docs — system architecture spec + bring-up/debug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
2026-06-23 Reframe docs around edge-AI compute in orbit
    Lead the documentation with KENSAT's primary mission — running LLM inference
    on a power-gated Jetson Orin Nano payload in orbit and downlinking results —
    and present the other subsystems as serving that goal. De-emphasize the
    single-engineer / first-individual framing in the top README, system
    architecture overview, and radio README.
2026-06-23 Add burn-wire board as Slot 4 to the physical stack
    The antenna-release burn-wire board (resistive heating) is the top board in
    the 2U stack. Update the stack diagram (README), the physical-stack table
    (system architecture), and the burn-wire / EPS slot references accordingly.
2026-06-23 Remove generated BOM and placement CSVs from hardware
    Drop the JLCPCB BOM and component-placement (pos/CPL) CSVs for the radio and
    burn-wire boards — these are generated fabrication outputs, not design sources.
    Ignore */hardware/*.csv going forward and update the radio/burn-wire READMEs.
2026-06-23 Remove SDR demodulator bring-up scratch scripts
    Drop the 16 one-off diagnose_*/find_carrier scripts written while bringing up
    the demodulator. They were heavily overlapping debug artifacts; the working
    result lives in beacon_decoder.py and pluto_rx_ax25.py. Trim the ground-station
    README accordingly.
2026-06-23 Add assembled CubeSat photo to README
    Embed a bench photo of the integrated 2U flatsat under the intro so the
    README leads with the physical hardware.
2026-09-15 Sync OBC firmware; add LLM prompt uplink and result text downlink
    Resync firmware/obc/app from the MPLAB working tree. What that brings in:
    the 1200 bps beacon compaction, MSB-first AX.25 bit packing, uplink RX
    with persistent commanded RF silence (commstate.h), cumulative counters
    checkpointed to the SD card, Idle-mode power saving with idle-fraction
    instrumentation, and reset-cause reporting in the beacon. bsp/ was
    already current. Source comments that referenced paths outside this repo
    now point at repo paths, and the Salvo/UART gotchas they relied on are
    written up as "Known issues" in firmware/obc/README.md.
    Downlink the inference text, not just how the run went. A result is up
    to 512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
2026-09-16 Uplink an LLM prompt in one frame with a 256-byte field
    Replace the six-chunk PR/PR?/PRX prompt protocol with a single telecommand:
    "KO6IKZ <AUTH> PROMPT " + field[256]
    The field is the prompt as printable ASCII, NUL-padded to exactly 256
    bytes. A valid PROMPT starts an inference on arrival and is acknowledged
    "PROMPT <n>B h=<crc32>" so the ground can confirm what was received. Bad
    fields are NAKed with the reason (len=, char@, pad@, empty); a repeat while
    the same run is pending is ACKed "dup" instead of queuing a second run, and
    a different prompt while the payload is busy is NAKed "busy". RUN with no
    argument now means the next library prompt. JETSON_PROMPT_MAX and the
    daemon's cap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
